N-B-Studio/5010-3DOF-Foc-kinematic-chain/3D Model/Let-Assembly.step

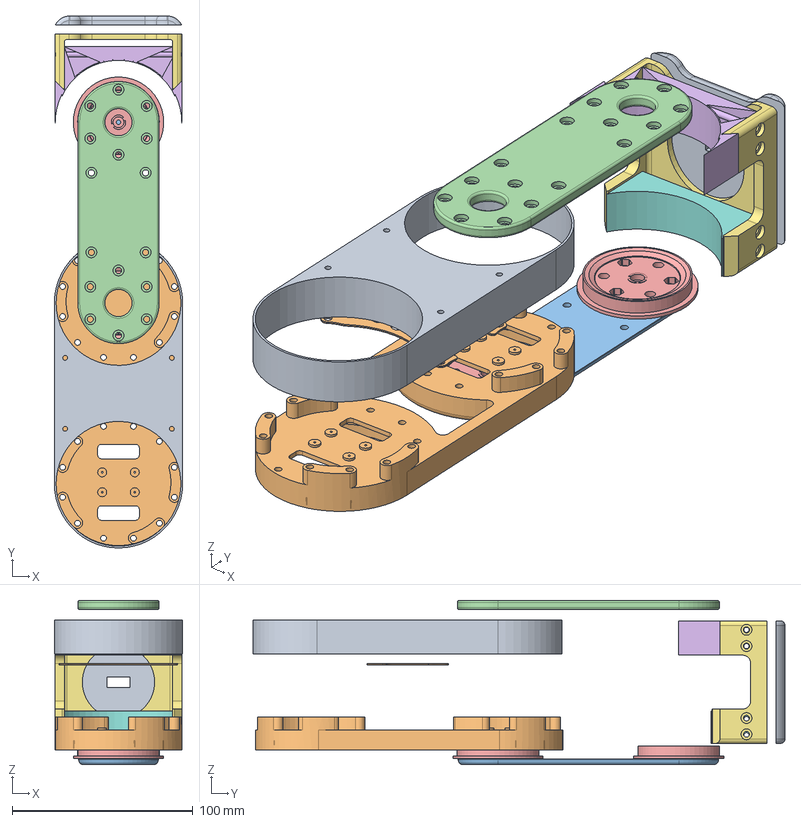
[picture p2: CAD file, 2026-09-17]
3D Model/Let-Assembly.step
71.0 x 294.2 x 90.7 mm
Upper-leg
Output - Bambu - Output Shaft Front x 2
Lower_leg
encoder-mount x 2
Foot
motor-mount
