N-B-Studio/5010-3DOF-Foc-kinematic-chain/STM32-H723/Core/Src/main.c

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
/* Includes ------------------------------------------------------------------*/
#include "main.h"
#include "dma.h"
#include "fdcan.h"
#include "spi.h"
#include "tim.h"
#include "usart.h"
#include "gpio.h"

/* USER CODE BEGIN Includes */
#include "leg_pd_poc.h"
/* USER CODE END Includes */

/* USER CODE BEGIN PV */
/* TIM2 IRQ releases one deterministic foreground 1 kHz controller iteration. */
volatile uint8_t loop_1khz_flag = 0U;
/* USER CODE END PV */

void SystemClock_Config(void);
/**
  * @brief  The application entry point.
  * @retval int
  */
int main(void)
{
  /* MCU Configuration--------------------------------------------------------*/
  HAL_Init();

  SystemClock_Config();

  MX_GPIO_Init();
  MX_DMA_Init();
  MX_SPI2_Init();
  MX_USART1_UART_Init();
  MX_TIM2_Init();
  MX_FDCAN1_Init();
  MX_FDCAN2_Init();
  MX_USART10_UART_Init();
  MX_SPI6_Init();

  /* USER CODE BEGIN 2 */
  /* Starts CAN RX, PC/G030 UART RX DMA, controlled 5 V, and BMI088. */
  LegPdPoc_Init();

  /* TIM2 must be configured in CubeMX for a real 1 kHz update interrupt. */
  if (HAL_TIM_Base_Start_IT(&htim2) != HAL_OK)
  {
    Error_Handler();
  }
  /* USER CODE END 2 */

  /* Infinite loop */
  /* USER CODE BEGIN WHILE */
  while (1)
  {
    /* USER CODE END WHILE */

    /* USER CODE BEGIN 3 */
    /* Non-blocking PC telemetry and WS2812 status service. */
    LegPdPoc_Service();

    if (loop_1khz_flag != 0U)
    {
      loop_1khz_flag = 0U;
      /* G030 state, BMI088 sample, safety checks, and outer torque PD. */
      LegPdPoc_Control1kHz();
    }
    /* USER CODE END 3 */
  }
  /* USER CODE END WHILE */
}

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
/* USER CODE BEGIN 4 */
void HAL_TIM_PeriodElapsedCallback(TIM_HandleTypeDef *htim)
{
  if (htim->Instance == TIM2)
  {
    loop_1khz_flag = 1U;
  }
}
/* USER CODE END 4 */
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
