N-B-Studio/5010-3DOF-Foc-kinematic-chain/G030-second-encoder/Core/Inc/main.h

#define LED_Pin GPIO_PIN_0
#define LED_GPIO_Port GPIOA
#define ENCODER_1_Pin GPIO_PIN_3
#define ENCODER_1_GPIO_Port GPIOA
#define ENCODER_2_Pin GPIO_PIN_4
#define ENCODER_2_GPIO_Port GPIOA
#define ENCODER_3_Pin GPIO_PIN_5
#define ENCODER_3_GPIO_Port GPIOA
#define FOOT_SW_Pin GPIO_PIN_8
#define FOOT_SW_GPIO_Port GPIOA
