N-B-Studio/5010-3DOF-Foc-kinematic-chain/(notices)

Notices in the files:
G030-second-encoder/Core/Inc/main.h:
Copyright (c) 2026 STMicroelectronics.
All rights reserved.
This software is licensed under terms that can be found in the LICENSE file
README.md:
License: MIT
